SteveMayze/FullChargeAhead/doc/TestAdapter.JPG

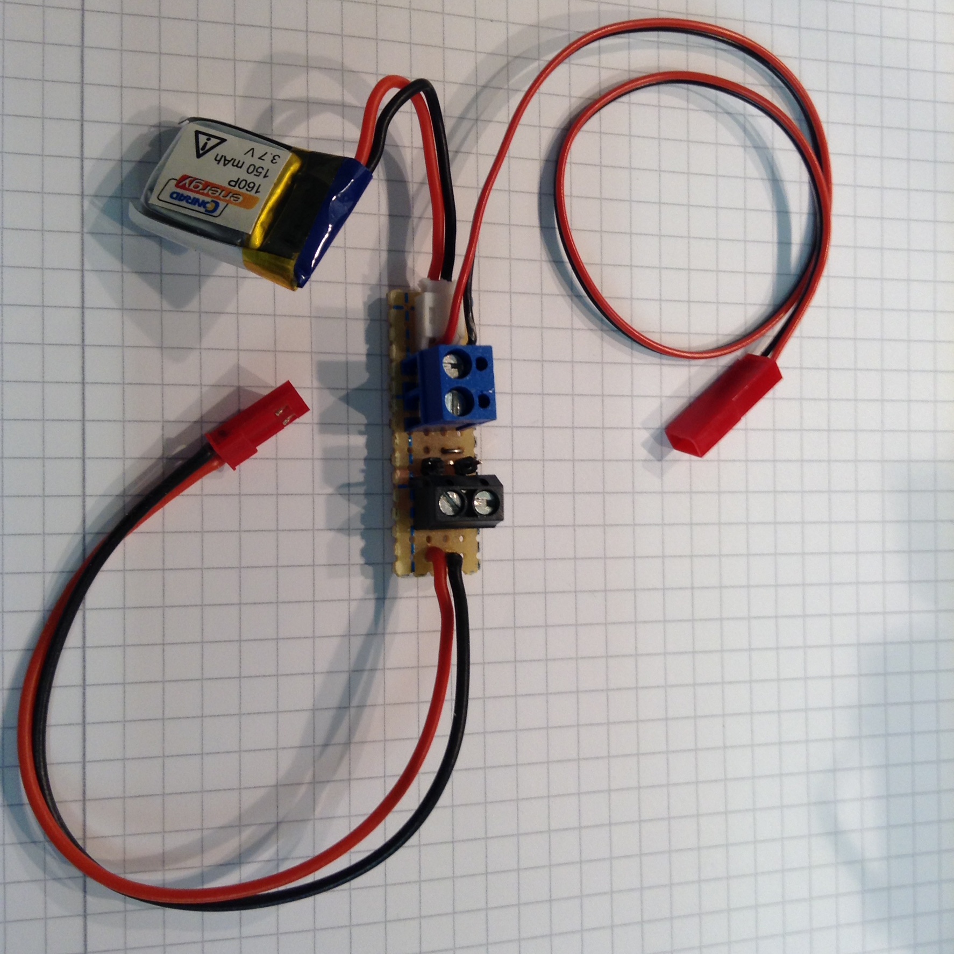
doc/TestAdapter.JPG
