SteveMayze/FullChargeAhead/doc/150mAh-Dicharge.numbers/preview-web.jpg

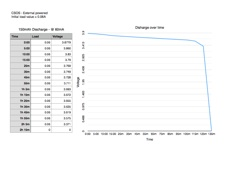
doc/150mAh-Dicharge.numbers/preview-web.jpg
