SteveMayze/FullChargeAhead/doc/BoardLayout.png

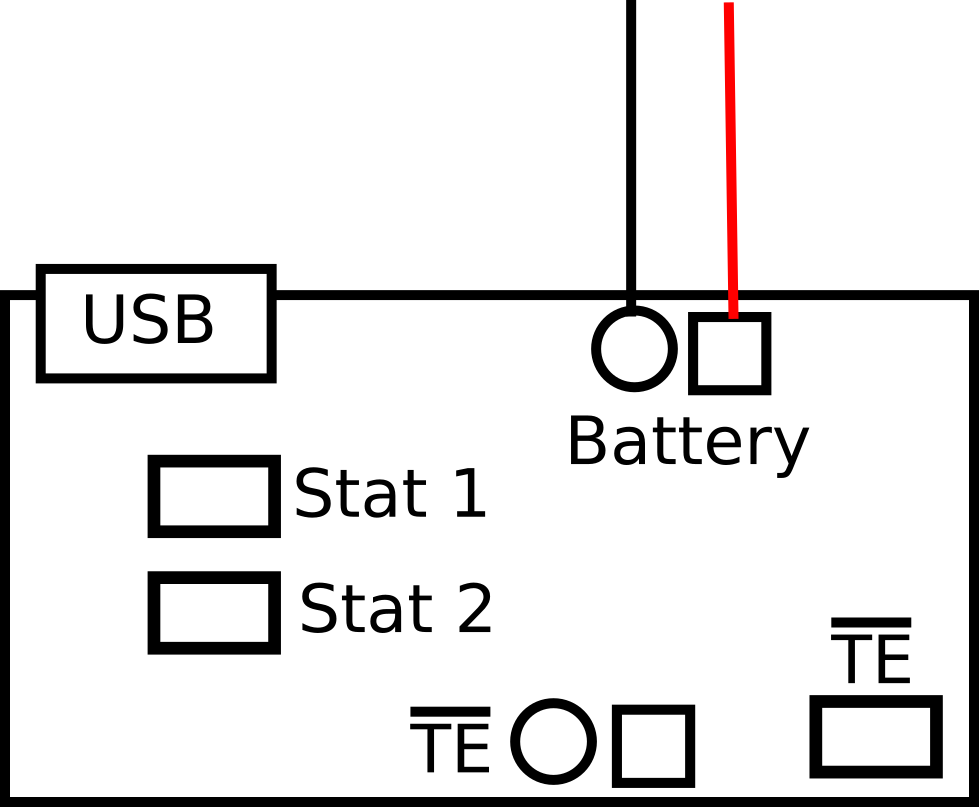
doc/BoardLayout.png
