SteveMayze/FullChargeAhead/doc/10118193.pdf

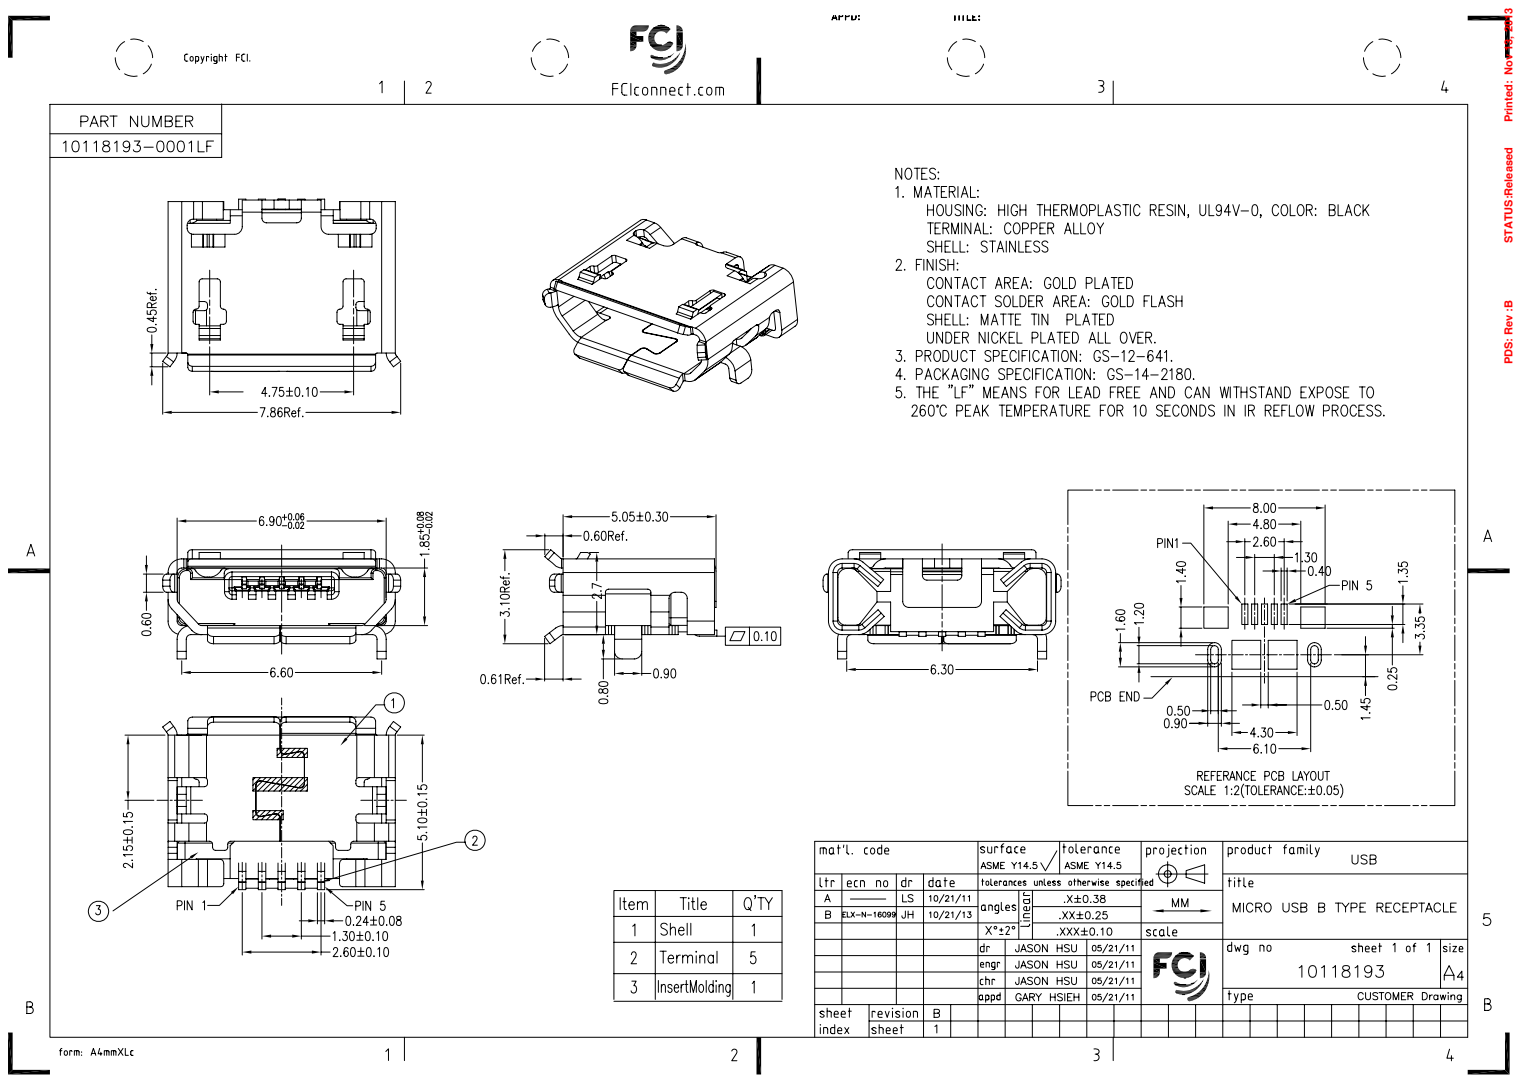
[picture p4: page 1]

PDS: Rev :B STATUS:Released Printed: Nov 13, 2013
