SteveMayze/FullChargeAhead/FullChargeAhead.kicad_pcb

## KiCad design FullChargeAhead.kicad_pcb (2015-03-31)

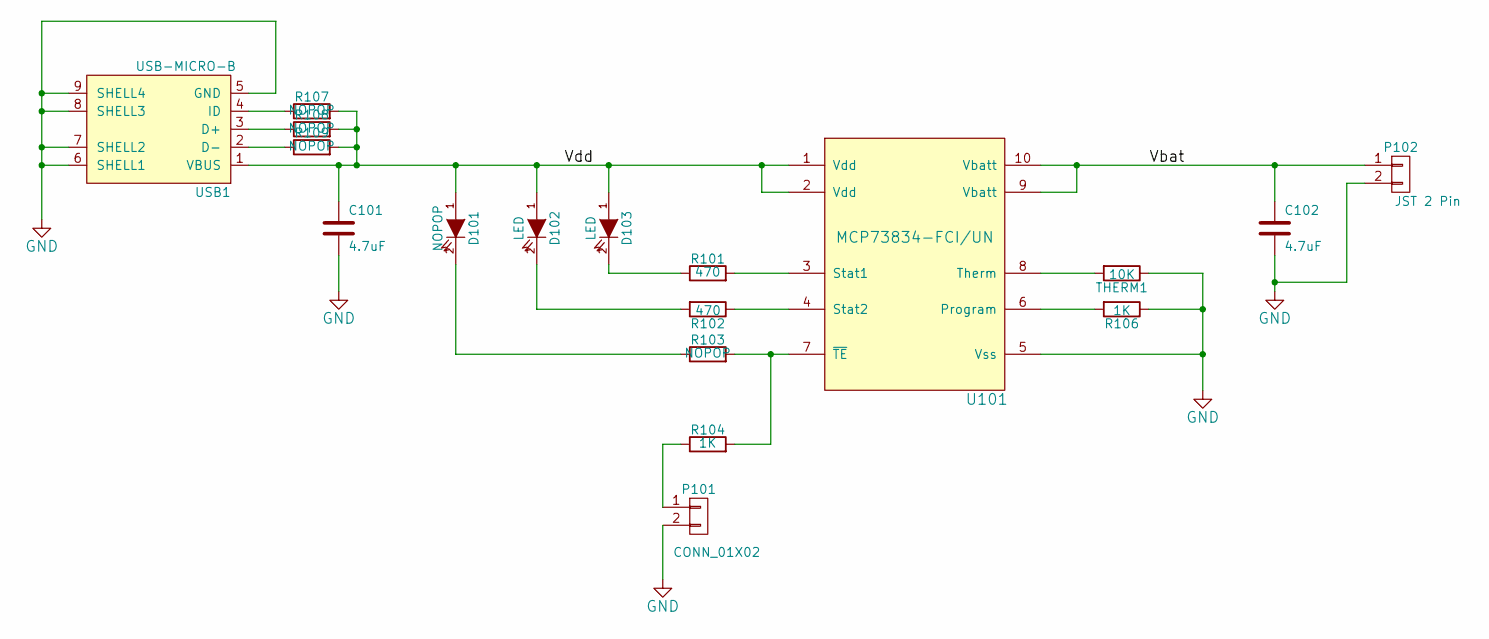
[picture p5: schematic FullChargeAhead.sch]

Parts:
C101, C102: 4.7uF; C_1206_HandSoldering; MPN Value
D101: NOPOP; LED-0805; MPN N/A
D102, D103: LED; LED-0805; MPN KP-2012EC
P101: CONN_01X02; Pin_Header_Straight_1x02
P102: JST 2 Pin; JST_2Pin; MPN S2B-PH-K-S
R101, R102: 470; R_0805_HandSoldering
R103, R107, R108, R109: NOPOP; R_0805_HandSoldering
R104, R106: 1K; R_0805_HandSoldering
THERM1: 10K; R_0805_HandSoldering
U101: MCP73834-FCI/UN; MSOP-10_3x3mm_Pitch0.5mm; MPN MCP73834-FCI/UN
USB1: USB-MICRO-B; USB_Micro_B; MPN 10118193-0001LF

Connections:
/Vbat: C102.1, P102.1, U101.9 (Vbatt), U101.10 (Vbatt)
/Vdd: C101.1, D101.1 (A), D102.1 (A), D103.1 (A), R107.2, R108.2, R109.2, U101.1 (Vdd), U101.2 (Vdd), USB1.1 (VBUS)
GND: C101.2, C102.2, P101.2, P102.2, R106.1, THERM1.1, U101.5 (Vss), USB1.5 (GND), USB1.6 (SHELL1), USB1.7 (SHELL2), USB1.8 (SHELL3), USB1.9 (SHELL4)
unnamed: D101.2 (K), R103.1
unnamed: D102.2 (K), R102.2
unnamed: D103.2 (K), R101.1
unnamed: P101.1, R104.1
unnamed: R101.2, U101.3 (Stat1)
unnamed: R102.1, U101.4 (Stat2)
unnamed: R103.2, R104.2, U101.7 (~TE)
unnamed: R106.2, U101.6 (Program)
unnamed: R107.1, USB1.4 (ID)
unnamed: R108.1, USB1.3 (D+)
unnamed: R109.1, USB1.2 (D-)
unnamed: THERM1.2, U101.8 (Therm)

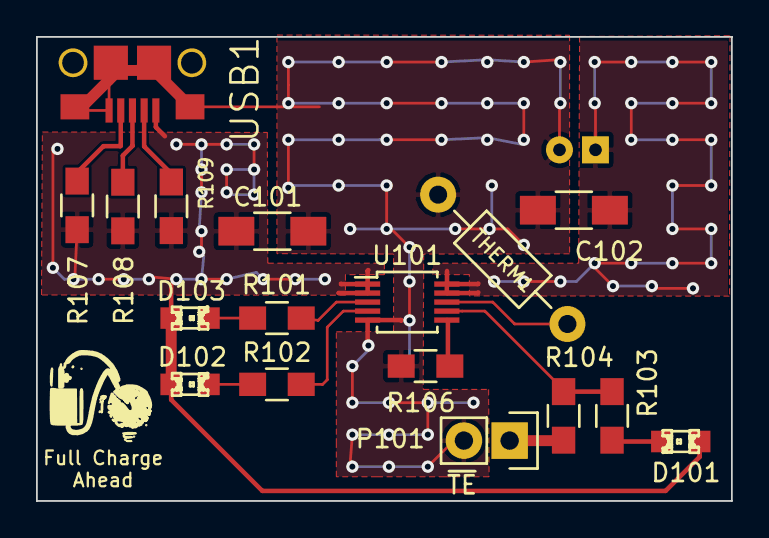
[picture p6: board FullChargeAhead.kicad_pcb from above]

Board: 2 copper layers, 38.6 x 25.8 mm, 18 parts (1 on the bottom side), 15 nets.
