SteveMayze/FullChargeAhead/doc/150mAh-CSOS-FCA-Test.pdf

### 150mAh Discharge - @ 60mA

Time | Load | Voltage
0:00 | 0.06 | 3.8779
5:00 | 0.06 | 3.860
10:00 | 0.06 | 3.83
15:00 | 0.06 | 3.79
25m | 0.06 | 3.769
35m | 0.06 | 3.749
45m | 0.06 | 3.728
55m | 0.06 | 3.711
1h 5m | 0.06 | 3.693
1h 15m | 0.06 | 3.672
1h 25m | 0.06 | 3.655
1h 35m | 0.06 | 3.635
1h 45m | 0.06 | 3.619
1h 55m | 0.06 | 3.575
2h 5m | 0.06 | 3.371
2h 15m | 0 | 0

### Disharge over time

Voltage

0 0.488 0.975 1.463 1.95 2.438 2.925 3.413 3.9

Time

0:00 5:00 10:00 15:00 25m 35m 45m 55m 65m 75m 85m 95m 105m 115m 125m 135m

CSOS - External powered
Initial load value = 0.06A

### 150mAh Recharge - @ 100mA Vdd 5V

Time | Current | Voltage
0:00 | 0.1 | 3.29
10:00 | 0.1 | 3.8
20:00 | 0.1 | 3.855
30m | 0.1 | 3.893
40m | 0.1 | 3.913
50m | 0.1 | 3.947
1h | 0.1 | 3.993
1h 10m | 0.1 | 4.05
1h 20m | 0.1 | 4.1
1h 30m | 0.09 | 4.17
1h 40m | 0.05 | 4.18
1h 50m | 0.03 | 4.18
2h | 0.02 | 4.19
2h 10m | 0.01 | 4.19
2h 20m | 0 | 4.17
2h 30m | 0 | 4.17
2h 40m | 0 | 4.17

### Recharge over time

Voltage

1 1.875 2.75 3.625 4.5

Time

0:00 10:0020:00 30m 40m 50m 60m 70m 80m 90m 100m 110m 120m130m140m150m160m

### Charge current over time

0

0.025

0.05

0.075

0.1

0:00 10:00 20:00 30m 40m 50m 60m 70m 80m 90m 100m 110m 120m 130m 140m 150m 160m
