SteveMayze/FullChargeAhead/doc/TestResults.ods

Sheet: Discharge
Time | Load | Voltage
0:00 | 0.06 | 3.8779
5:00 | 0.06 | 3.86
10:00 | 0.06 | 3.83
15:00 | 0.06 | 3.79
25m | 0.06 | 3.769
35m | 0.06 | 3.749
45m | 0.06 | 3.728
55m | 0.06 | 3.711
65m | 0.06 | 3.693
75m | 0.06 | 3.672
85m | 0.06 | 3.655
95m | 0.06 | 3.635
105m | 0.06 | 3.619
115m | 0.06 | 3.575
125m | 0.06 | 3.371
135m | 0 | 0

Sheet: Recharge
Time | Current | Voltage
0:00 | 0.100 | 3.290
10:00 | 0.100 | 3.800
20:00 | 0.100 | 3.855
30m | 0.100 | 3.893
40m | 0.100 | 3.913
50m | 0.100 | 3.947
60m | 0.100 | 3.993
70m | 0.100 | 4.050
80m | 0.100 | 4.100
90m | 0.090 | 4.170
100m | 0.050 | 4.180
110m | 0.030 | 4.180
120m | 0.020 | 4.190
130m | 0.010 | 4.190
140m | 0.000 | 4.170
150m | 0.000 | 4.170
160m | 0.000 | 4.170
