SteveMayze/FullChargeAhead/(commit log)

2015-03-21 Initial checkin of the schematic
    [FullChargeAhead.sch]
2015-03-23 Added the new library, created the micro usb foot print and started the layout
    [FullChargeAhead.kicad_pcb, FullChargeAhead.sch]
2015-03-27 Model update after component resze
    [FullChargeAhead.kicad_pcb, FullChargeAhead.sch]
2015-03-28 Preperation for layout
    [FullChargeAhead.kicad_pcb, FullChargeAhead.sch]
2015-03-28 Corrected the footprint for the JST connector
    [FullChargeAhead.kicad_pcb, FullChargeAhead.sch]
2015-03-29 Front Cu Layout done
    [FullChargeAhead.kicad_pcb, FullChargeAhead.sch]
2015-03-29 Back Cu Layout and changes to front Cu. Also edge cuts added
    [FullChargeAhead.kicad_pcb]
2015-03-29 Back Cu Layout and changes to front Cu. Also edge cuts added #2
    [FullChargeAhead.kicad_pcb]
2015-03-29 Base vias for stitching added
    [FullChargeAhead.kicad_pcb]
2015-03-29 Via stitched
    [FullChargeAhead.kicad_pcb]
2015-03-29 Completed layout and archive for Oshpark
    [FullChargeAhead-B_Cu.gbl, FullChargeAhead-B_Mask.gbs, FullChargeAhead-B_SilkS.gbo, FullChargeAhead-Edge_Cuts.gbr, FullChargeAhead-F_Cu.gtl, FullChargeAhead-F_Mask.gts, FullChargeAhead-F_SilkS.gto, FullChargeAhead.drl]
2015-03-30 Final layout and oshpark review
    [FullChargeAhead-B_Cu.gbl, FullChargeAhead-B_Mask.gbs, FullChargeAhead-B_SilkS.gbo, FullChargeAhead-Edge_Cuts.gbr, FullChargeAhead-F_Cu.gtl, FullChargeAhead-F_Mask.gts, FullChargeAhead-F_SilkS.gto, FullChargeAhead.drl]
2015-03-30 The last final layout and shpark review
    [FullChargeAhead-B_Cu.gbl, FullChargeAhead-B_Mask.gbs, FullChargeAhead-B_SilkS.gbo, FullChargeAhead-Edge_Cuts.gbr, FullChargeAhead-F_Cu.gtl, FullChargeAhead-F_Mask.gts, FullChargeAhead-F_SilkS.gto, FullChargeAhead.drl]
2015-03-31 Started BOM
    [FullChargeAhead.csv, FullChargeAhead.sch]
2015-03-31 More on the BOM
    [FullChargeAhead.kicad_pcb]
2015-03-31 BOM and script
    [FullChargeAhead.csv]
2015-05-16 Some changes and test results
    [FullChargeAhead.sch]
2015-11-22 Updated the documentation
    [Discharge-150mAh Discharge - @ 60mA.csv, FullChargeAhead.sch, Recharge-150mAh Recharge - @ 100mA Vdd 5V.csv, TestResults.ods]
